coddingtonbear/runge/readme.md

# Runge: Convert a Sboly Coffee Grinder into a Doser
