coddingtonbear/runge/hardware/controller/controller/controller.kicad_pcb

## KiCad design hardware/controller/controller/controller.kicad_pcb (2021-03-21)

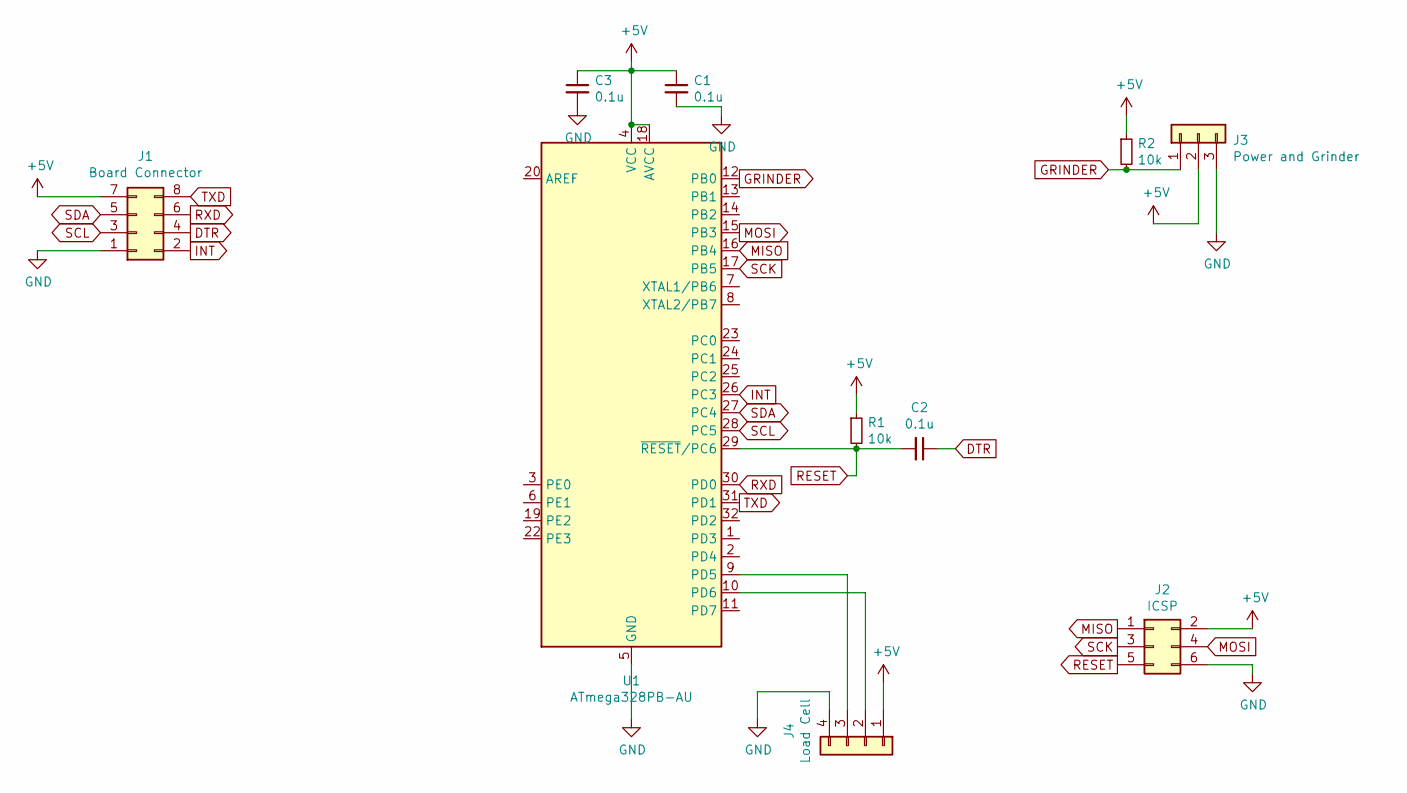
[picture p1: schematic controller.sch]

Parts:
C1, C2, C3: 0.1u; 0805_Milling
J1: Board Connector; IDC-Header_2x04_P2.54mm_Vertical
J2: ICSP; PinHeader_2x03_P2.54mm_Vertical
J3: Power and Grinder; PinHeader_1x03_P2.54mm_Vertical
J4: Load Cell; PinHeader_1x04_P2.54mm_Vertical
R1, R2: 10k; 0805_Milling
U1: ATmega328PB-AU; TQFP-32_7x7mm_P0.8mm

Connections:
+5V: C1.1, C3.1, J1.7, J2.2, J3.2, J4.1, R1.1, R2.1, U1.4 (VCC), U1.18 (AVCC)
DTR: C2.1, J1.4
GND: C1.2, C3.2, J1.1, J2.6, J3.3, J4.4, U1.5 (GND), U1.21 (GND)
GRINDER: J3.1, R2.2, U1.12 (PB0)
INT: J1.2, U1.26 (PC3)
MISO: J2.1, U1.16 (PB4)
MOSI: J2.4, U1.15 (PB3)
unnamed: J4.2, U1.10 (PD6)
unnamed: J4.3, U1.9 (PD5)
RESET: C2.2, J2.5, R1.2, U1.29 (~RESET~/PC6)
RXD: J1.6, U1.30 (PD0)
SCK: J2.3, U1.17 (PB5)
SCL: J1.3, U1.28 (PC5)
SDA: J1.5, U1.27 (PC4)
TXD: J1.8, U1.31 (PD1)

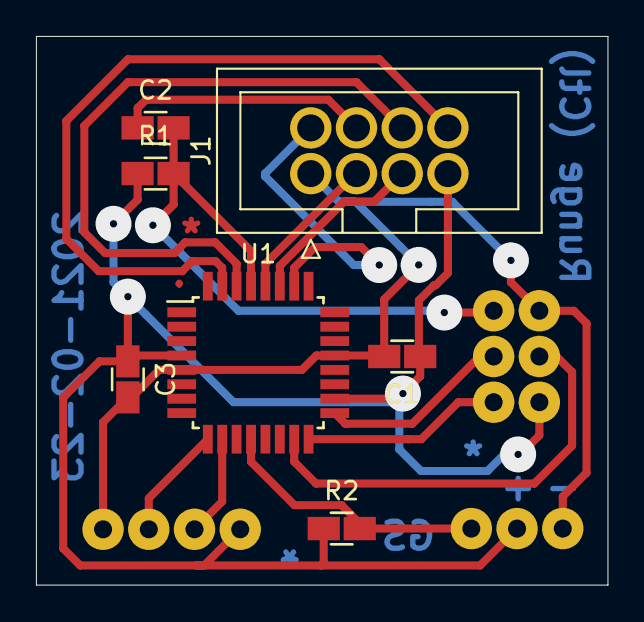
[picture p2: board controller.kicad_pcb from above]

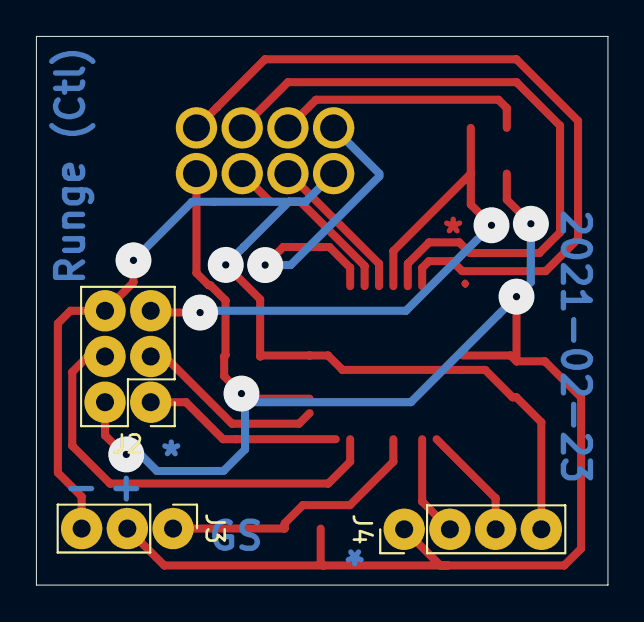
[picture p3: board controller.kicad_pcb from below]

Board: 2 copper layers, 31.8 x 30.5 mm, 10 parts (3 on the bottom side), 15 nets.
