coddingtonbear/runge/hardware/interface/interface.kicad_pcb

## KiCad design hardware/interface/interface.kicad_pcb (2021-02-24)

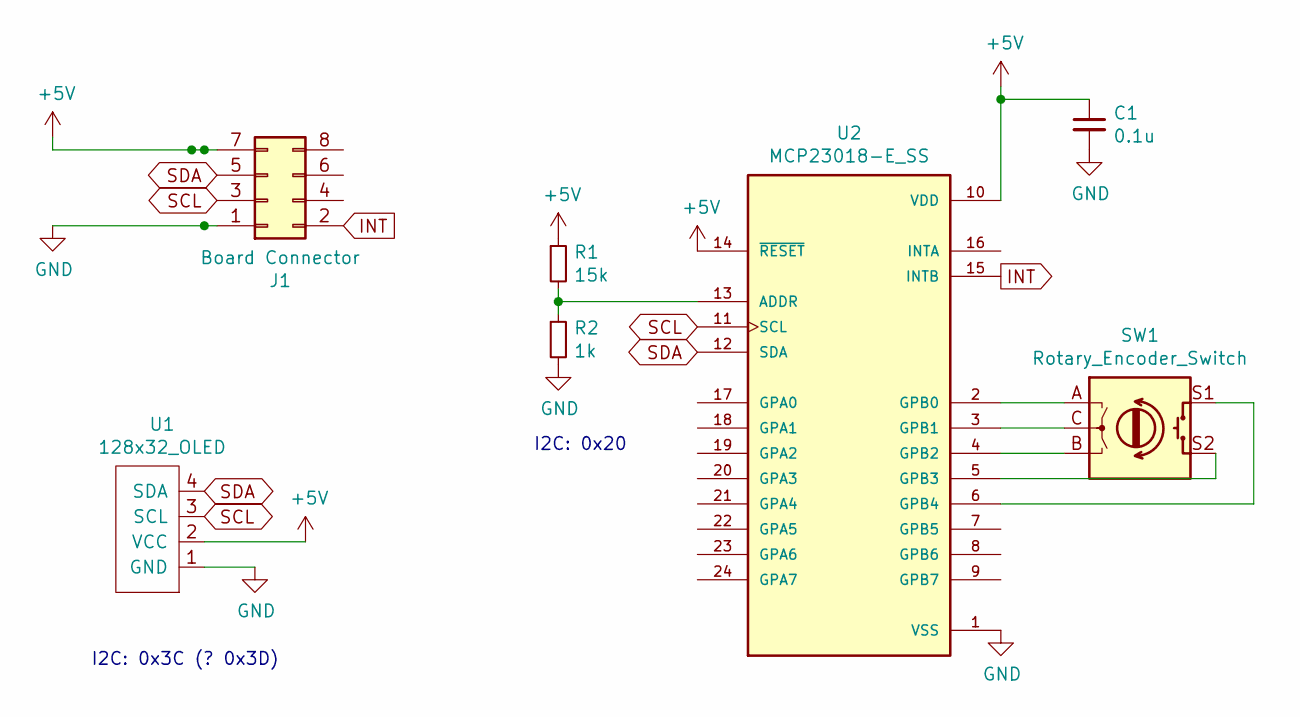
[picture p4: schematic interface.sch]

Parts:
C1: 0.1u; 0805_Milling
J1: Board Connector; IDC-Header_2x04_P2.54mm_Vertical
R1: 15k; 0805_Milling
R2: 1k; 0805_Milling
SW1: Rotary_Encoder_Switch; RotaryEncoder_Alps_EC12E-Switch_Vertical_H20mm
U1: 128x32_OLED
U2: MCP23018-E_SS; SSOP-24_5.3x8.2mm_P0.65mm; PARTREV N/A

Connections:
+5V: C1.1, J1.7, R1.1, U1.2 (VCC), U2.10 (VDD), U2.14 (~RESET)
GND: C1.2, J1.1, R2.2, U1.1 (GND), U2.1 (VSS)
INT: J1.2, U2.15 (INTB)
unnamed: R1.2, R2.1, U2.13 (ADDR)
unnamed: SW1.A, U2.2 (GPB0)
unnamed: SW1.B, U2.4 (GPB2)
unnamed: SW1.C, U2.3 (GPB1)
unnamed: SW1.S1, U2.6 (GPB4)
unnamed: SW1.S2, U2.5 (GPB3)
SCL: J1.3, U1.3 (SCL), U2.11 (SCL)
SDA: J1.5, U1.4 (SDA), U2.12 (SDA)

Notes on the sheet:
I2C: 0x3C (? 0x3D)
I2C: 0x20

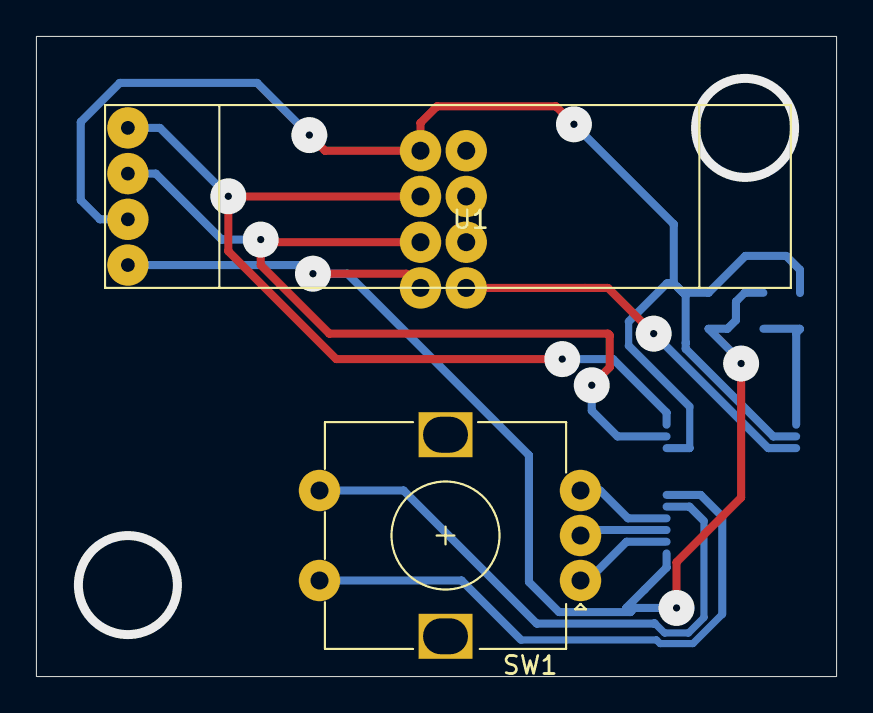
[picture p5: board interface.kicad_pcb from above]

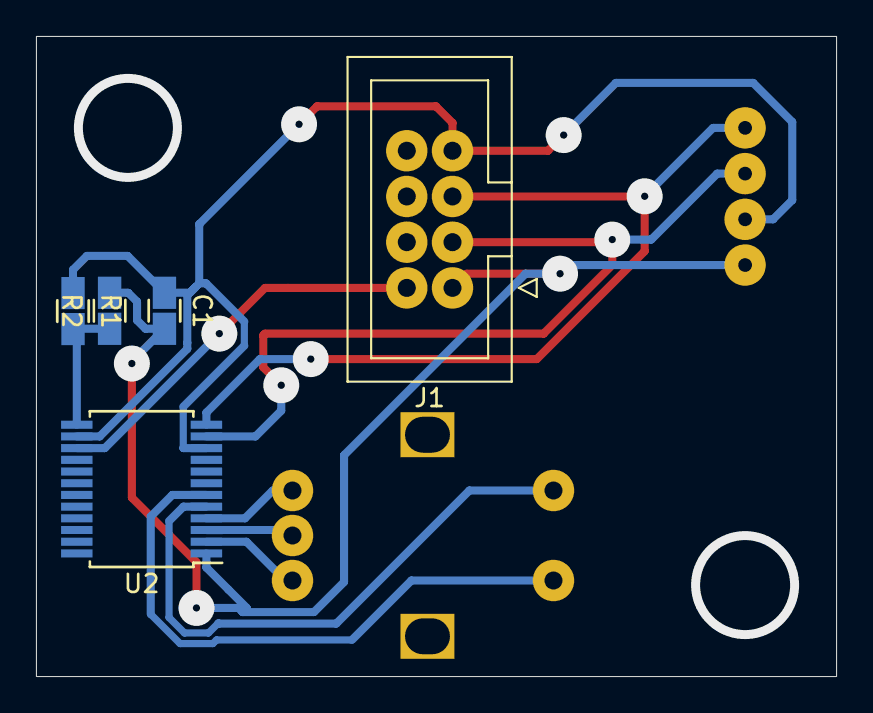
[picture p6: board interface.kicad_pcb from below]

Board: 2 copper layers, 44.4 x 35.6 mm, 7 parts (5 on the bottom side), 11 nets.
