coddingtonbear/runge/(commit log)

2021-02-14 And so it begins.
    [runge.kicad_pcb, runge.sch]
2021-02-14 Separate projects per-board.
    [interface.kicad_pcb, interface.sch]
2021-02-14 Fixing via sizes.
    [interface.kicad_pcb]
2021-02-14 Fixing mounting hole sizes.
    [interface.kicad_pcb]
2021-02-15 Whoops; the connector should be on the back side of the board.
    [interface.kicad_pcb, interface.sch]
2021-02-16 Adding firmware prototype.
2021-02-16 Fixing button behavior.
2021-02-16 Just...poll the buttons; the interrupt-based method was a little too buggy.
    [main.cpp]
2021-02-16 Do not display a calibration completed message.
2021-02-17 Adding new controller board.
    [controller.kicad_pcb, controller.sch]
2021-02-17 Adding connector for load cell amplifier board.
    [controller.kicad_pcb, controller.sch]
2021-02-24 Updating interface PCB.
    [interface.kicad_pcb]
2021-02-24 Updating runge controller for new milling process.
    [controller.kicad_pcb]
2021-03-21 Final weight-based method for dosing.
    [controller.kicad_pcb]
2021-03-22 Switching to time-based dosing (for the moment).
    When doing initial experiments with the assembled project, the weight
    measurements were found to be going a little crazy the moment the motor
    turned on. I'm not at the moment sure whether the problem is EMI from
    the motor, or if it's just vibration. In any case, the load cell method
    is non-viable for the moment, and I need my coffee grinder. So:
    time-based measurements it is for now.
    [main.cpp]
2021-05-22 Automatically reset after we've made it through half of the ticks that can fit into an unsigned long.
    [main.cpp]
2021-05-22 Automatically reset wdt at start.
    [main.cpp]
2021-05-22 Prevent underflow of ulong due to time progressing throughout the loop.
    [main.cpp]
2021-05-22 Handle disconnection from controller board.
2021-05-22 Adds a lockout state for certain error cases.
    - If the grinder has been running for longer than 30s; something
    has gone terribly awry. Shows "ERR: GndT" in such a case.
    - If the interface can't be reached for some reason; we can't
    read button state. Shows "ERR: IfcP" in such a case.
    [main.cpp]
2021-05-22 Swapping fonts to match startup font.
    [main.cpp]
